gerrishp2/HomeOilTankLevel/Wiring Cartoon (2).jpg

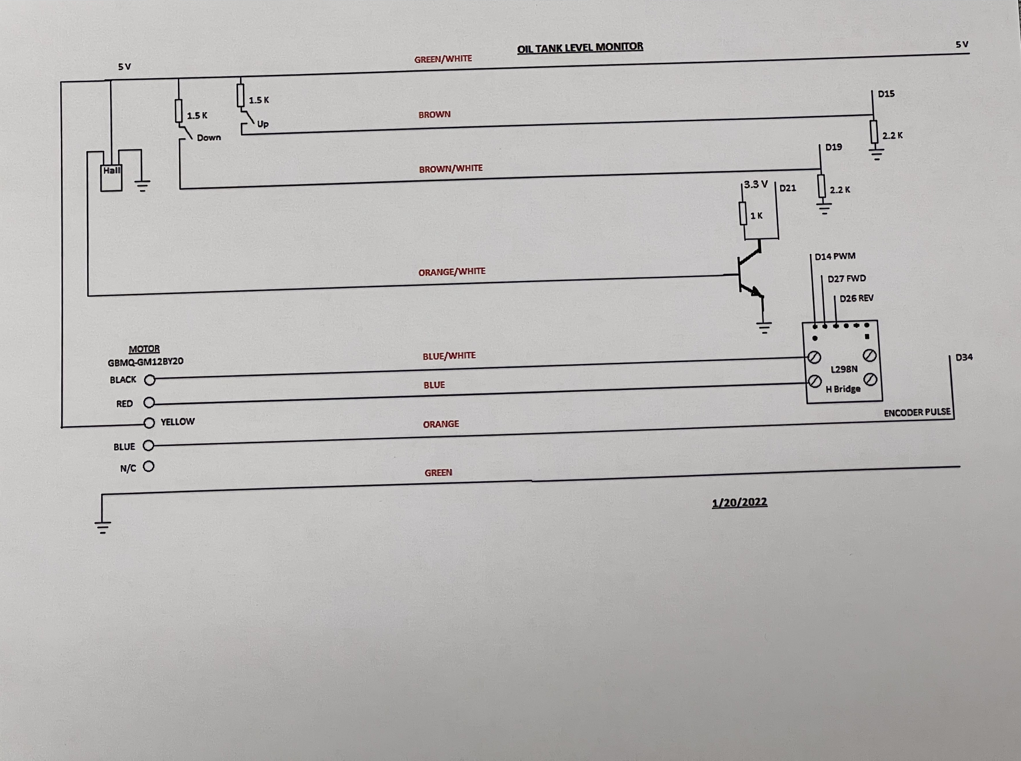
Wiring Cartoon (2).jpg
