gerrishp2/HomeOilTankLevel/Picture.JPG

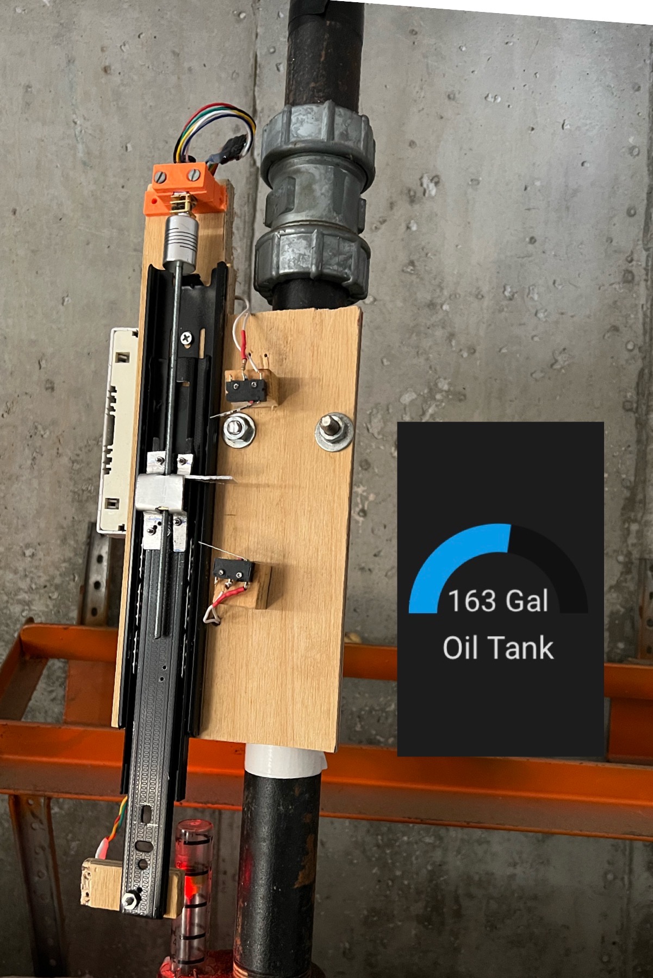
Picture.JPG
