gerrishp2/HomeOilTankLevel/MotorMount.obj

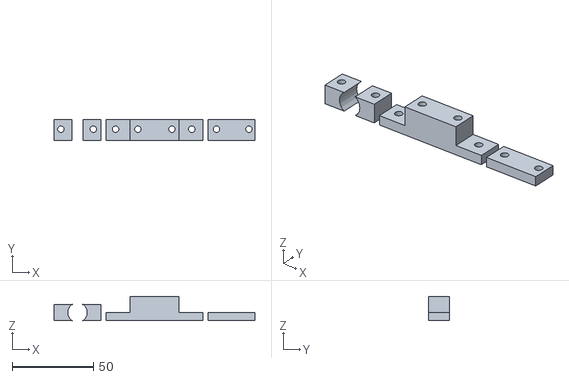
[picture p3: CAD file, 2022-03-11]
MotorMount.obj
124.0 x 13.0 x 15.0
