gerrishp2/HomeOilTankLevel/(commit log)

2022-03-11 Add files via upload
    3D Printer file for Motor Mount.
    [MotorMount.obj]
2022-03-11 Add files via upload
    Picture of the system mounted on my tank
